hamztion/Person-following-Rover-Project/(commit log)

2026-05-07 Control Flowchart puml + png
2026-05-12 Added final schematic
